hardware-designs-iai/tiago_robotiq_adapter/(list of files, cad)

Other CAD files:
mounting_adapter/3D_Mechanical_parts_v1.1/Tiago_UR5_Mechanical_drawing.ipt
mounting_adapter/3D_Mechanical_parts_v1.2/Robotiq_gripper_Mechanical_drawing.ipt
