hardware-designs-iai/tiago_robotiq_adapter/(commit log)

2024-06-03 1. ESP32-S3 bridge board for Robotiq gripper ,2.Added circuit design for the DC-DC converter 3. Generated production files including Gerber files,drill,BOM files
    [TIAGO_gripper.kicad_pcb, TIAGO_gripper.kicad_sch, dc-dc_converter.kicad_sch]
2024-06-26 1.Fix Rs485 communicaton
    [TIAGO_gripper.kicad_pcb, dc-dc_converter.kicad_sch]
2024-07-03 Included bom.csv and positions.csv files
    [bom.csv, positions.csv]
2024-07-03 Firmware for Robotiq gripper and TIAGo
2024-08-07 Change DC-DC converter to 60V version
    [TIAGO_gripper.kicad_pcb, bom.csv, dc-dc_converter.kicad_sch]
2024-08-08 Removed .ipt from gitignore file
    [Robotiq_gripper_Mechanical_drawing.ipt, Tiago_UR5_Mechanical_drawing.ipt]
2024-10-15 Update production files to newer version
    [TIAGO_gripper.kicad_pcb, bom.csv, positions.csv]
2026-07-01 improve UART data reading robustness
